PriyanshNautiyal/Motion_Detector/README.md

# Motion_Detector
A motion detector project using the ESP32 Dev Module.
